umeshjoshi-dev/Speed_Control_of_DC_Motor/images/circuit/arduino_pinout.png

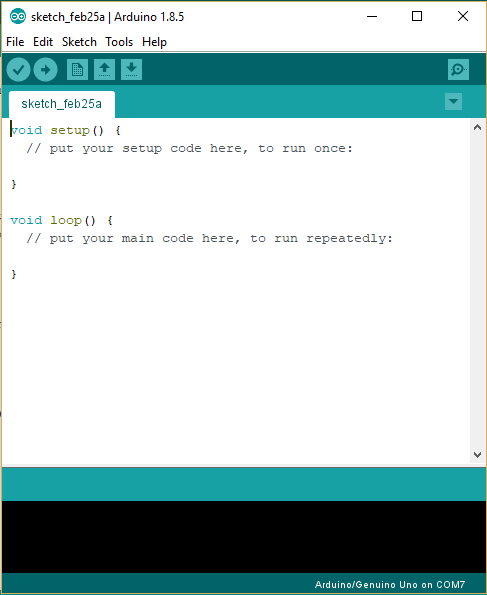
images/circuit/arduino_pinout.png
