umeshjoshi-dev/Speed_Control_of_DC_Motor/images/circuit/igbt_operation.gif

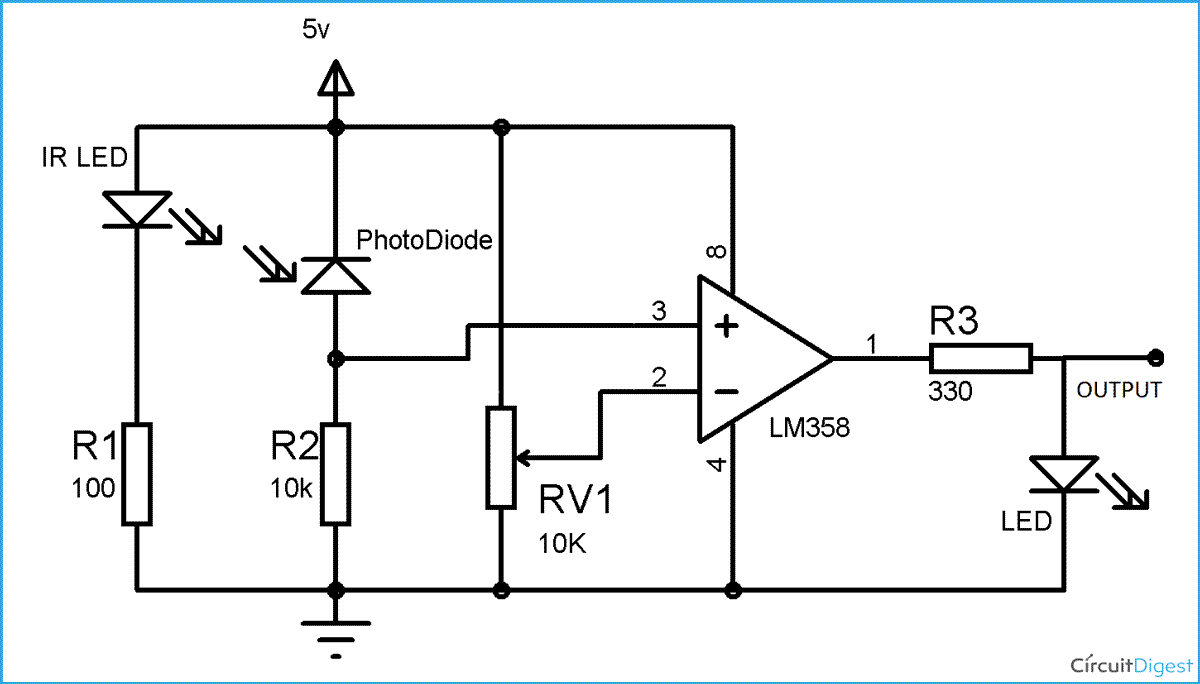
images/circuit/igbt_operation.gif
